jakubprzybytek/RGB-Chain/README.md

#### ToDo
* Fix 3V3 / 5V converter so it works faster
