jakubprzybytek/RGB-Chain/KiCad/RGBChain/RGBChain.kicad_pcb

## KiCad design KiCad/RGBChain/RGBChain.kicad_pcb (2020-12-15)

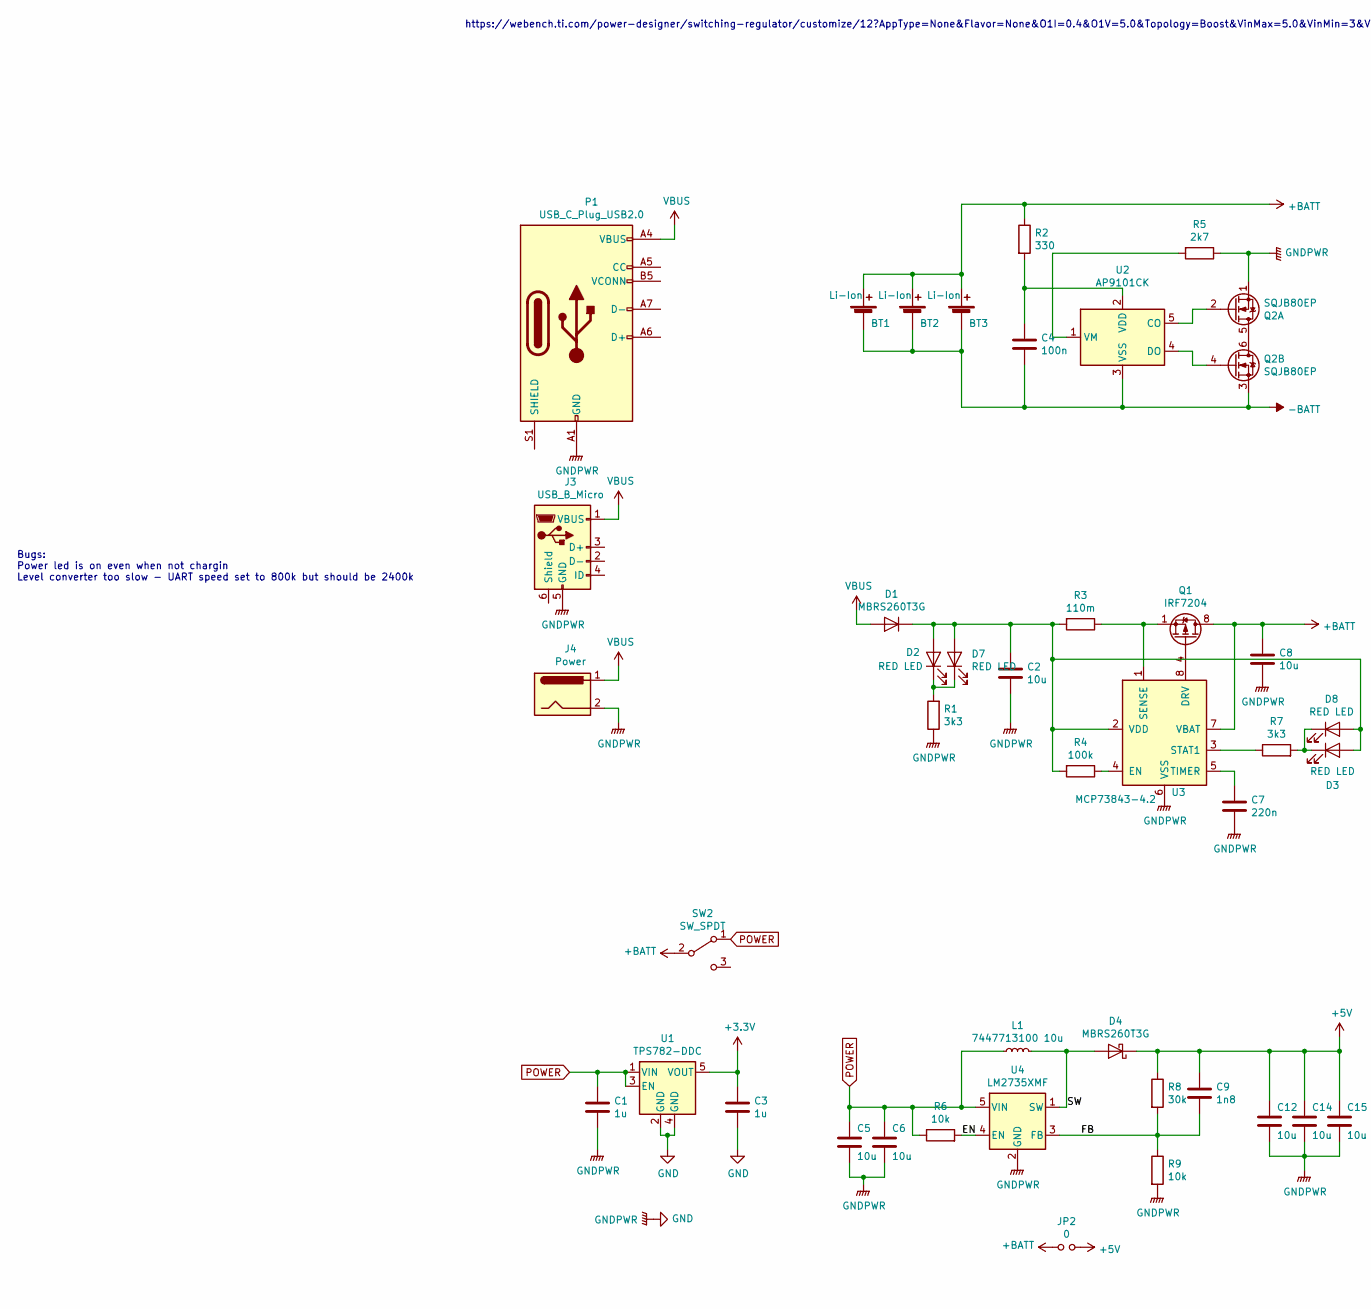
[picture p1: schematic RGBChain.sch, part in row 1, column 1]

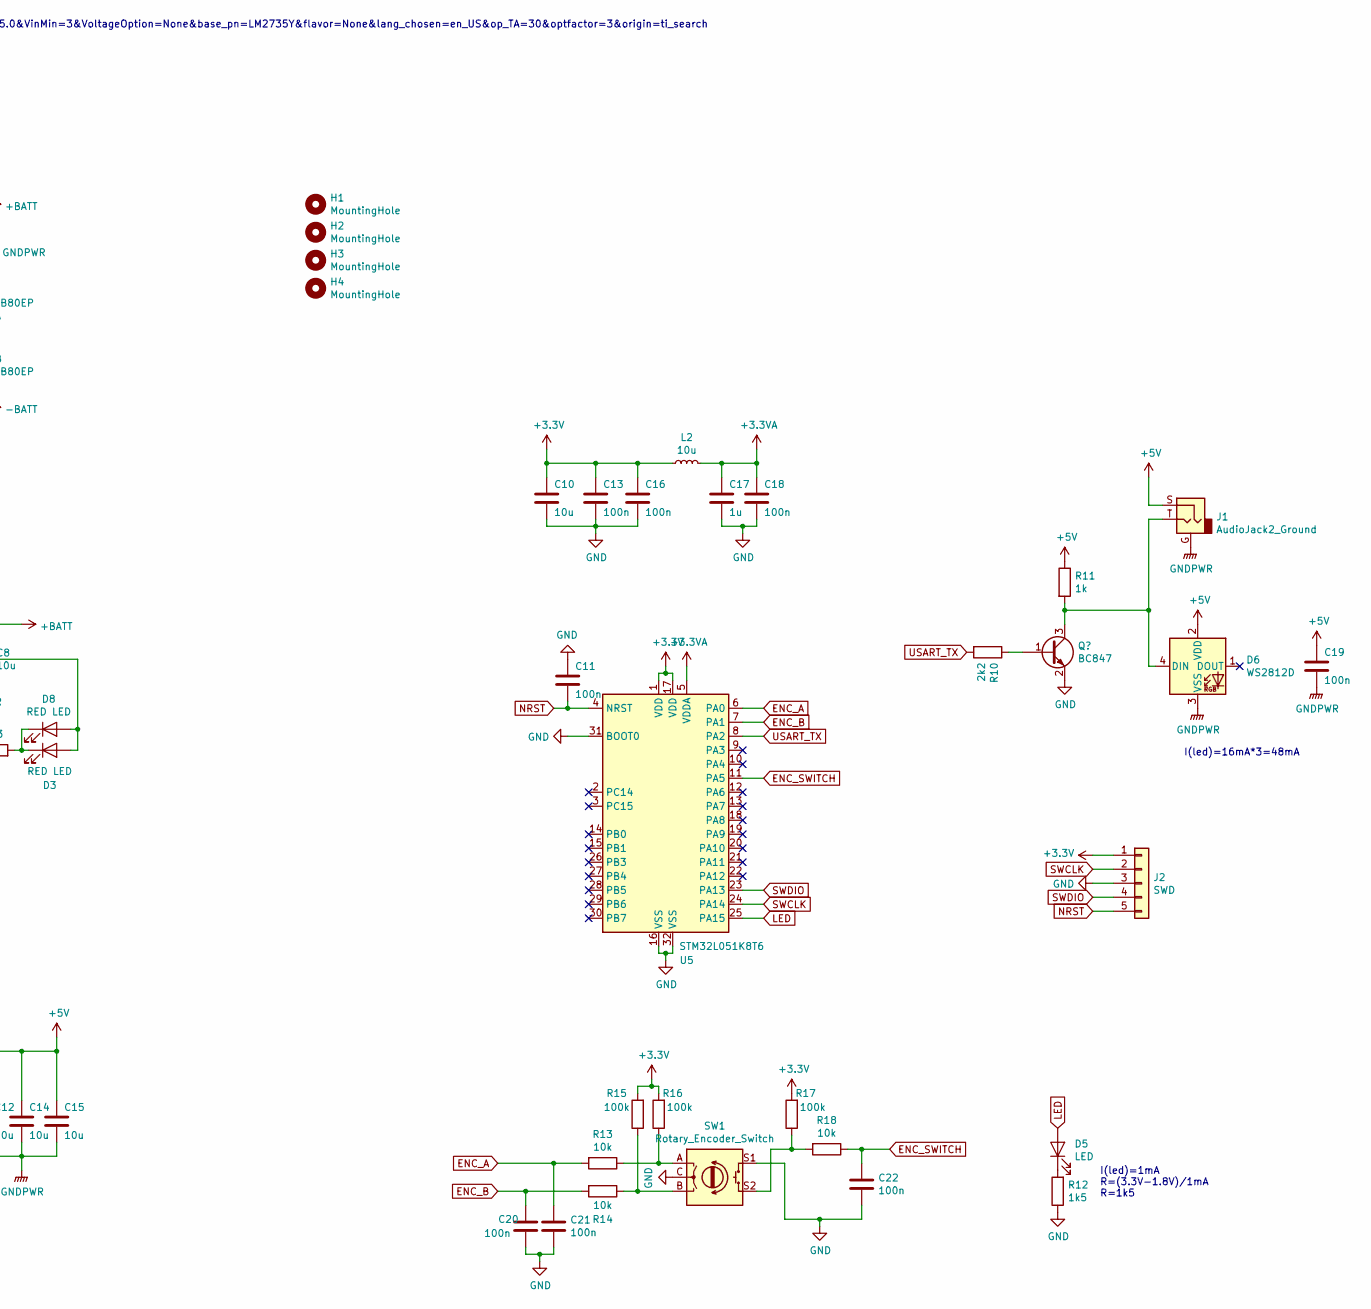
[picture p2: schematic RGBChain.sch, part in row 1, column 2]

Parts:
BT1, BT2, BT3: Li-Ion; BatteryHolder_Keystone_1042_1x18650
C1, C3, C17: 1u; C_0805_2012Metric
C2, C5, C6, C8, C10, C12, C14, C15: 10u; C_0805_2012Metric
C4, C11, C13, C16, C18, C19, C20, C21, C22: 100n; C_0603_1608Metric
C7: 220n; C_0805_2012Metric
C9: 1n8; C_0805_2012Metric
D1, D4: MBRS260T3G; D_SMB
D2, D3: RED LED; LED_0805_2012Metric
D5: LED; LED_0805_2012Metric
D6: WS2812D; LED_D5.0mm-4_RGB
D7, D8: RED LED; LED_D3.0mm
H1, H2, H3, H4: MountingHole; MountingHole_3.2mm_M3
J1: AudioJack2_Ground; Jack_3.5mm_Lumberg_1503_03
J2: SWD; PinHeader_1x05_P2.54mm_Vertical
J3: USB_B_Micro; USB_Micro-B_Molex_47346-0001
J4: Power; PowerSocketSMD
JP2: 0; SolderJumper-2_P1.3mm_Open_Pad1.0x1.5mm
L1: 7447713100 10u; L_Wuerth_WE-PDF_Handsoldering
L2: 10u; L_0805_2012Metric
P1: USB_C_Plug_USB2.0; USB_C_Receptacle_Adam_Tech
Q1: IRF7204; SOIC-8_3.9x4.9mm_P1.27mm
Q2: SQJB80EP; PowerPAK_SO-8_Dual
R1, R7: 3k3; R_0805_2012Metric
R2: 330; R_0805_2012Metric
R3: 110m; R_2512_6332Metric
R4, R15, R16, R17: 100k; R_0603_1608Metric
R5: 2k7; R_0805_2012Metric
R6, R13, R14, R18: 10k; R_0603_1608Metric
R8: 30k; R_0805_2012Metric
R9: 10k; R_0805_2012Metric
R10: 2k2; R_0603_1608Metric
R11: 1k; R_0805_2012Metric
R12: 1k5; R_0805_2012Metric
SW1: Rotary_Encoder_Switch; RotaryEncoder_Alps_EC11E-Switch_Vertical_H20mm_CircularMoun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
SW2: SW_SPDT; NINIGI_5F_M6
U1: TPS782-DDC; SOT-23-5
U2: AP9101CK; SOT-23-5
U3: MCP73843-4.2; MSOP-8_3x3mm_P0.65mm
U4: LM2735XMF; SOT-23-5
U5: STM32L051K8T6; LQFP-32_7x7mm_P0.8mm

Connections:
+3.3VA: C17.1, C18.1, L2.2, U5.5 (VDDA)
+3V3: C3.1, C10.1, C13.1, C16.1, J2.1, L2.1, R15.2, R16.2, R17.2, U1.5 (VOUT), U5.1 (VDD), U5.17 (VDD)
+5V: C9.1, C12.1, C14.1, C15.1, C19.1, D4.1 (K), D6.2 (VDD), J1.S, JP2.2, R8.1, R11.1
+BATT: BT1.1 (+), BT2.1 (+), BT3.1 (+), C8.1, JP2.1, Q1.5 (D), Q1.6 (D), Q1.7 (D), Q1.8 (D), R2.1, SW2.2 (B), U3.7 (VBAT)
-BATT: BT1.2 (-), BT2.2 (-), BT3.2 (-), C4.2, Q2.3 (S2), U2.3 (VSS)
/EN: R6.2, U4.4 (EN)
/FB: C9.2, R8.2, R9.1, U4.3 (FB)
/SW: D4.2 (A), L1.2, U4.1 (SW)
ENC_A: C21.1, R13.2, U5.6 (PA0)
ENC_B: C20.1, R14.2, U5.7 (PA1)
ENC_SWITCH: C22.1, R18.1, U5.11 (PA5)
LED: D5.2 (A), U5.25 (PA15)
NRST: C11.2, J2.5, U5.4 (NRST)
unnamed: C2.1, D1.1 (K), D2.2 (A), D3.2 (A), D7.2 (A), D8.2 (A), R3.2, R4.2, U3.2 (VDD)
unnamed: C4.1, R2.2, U2.2 (VDD)
unnamed: C7.1, U3.5 (TIMER)
unnamed: D2.1 (K), D7.1 (K), R1.2
unnamed: D3.1 (K), D8.1 (K), R7.2
unnamed: D5.1 (K), R12.2
unnamed 20: D6.4 (DIN), J1.T, R11.2; also elsewhere on the board
unnamed: Q1.1 (S), Q1.2 (S), Q1.3 (S), R3.1, U3.1 (SENSE)
unnamed: Q1.4 (G), U3.8 (DRV)
unnamed: Q2.2 (G2), U2.5 (CO)
unnamed: Q2.4 (G2), U2.4 (DO)
unnamed: Q2.5 (D2), Q2.6 (D2)
unnamed: R4.1, U3.4 (EN)
unnamed: R5.2, U2.1 (VM)
unnamed: R7.1, U3.3 (STAT1)
unnamed: R13.1, R16.1, SW1.A
unnamed: R14.1, R15.1, SW1.B
unnamed: R17.1, R18.2, SW1.S2
POWER: C1.1, C5.1, C6.1, L1.1, R6.1, SW2.1 (A), U1.1 (VIN), U1.3 (EN), U4.5 (VIN)
SWCLK: J2.2, U5.24 (PA14)
SWDIO: J2.4, U5.23 (PA13)
VBUS: D1.2 (A), J3.1 (VBUS), J4.1, P1.A4 (VBUS), P1.A9 (VBUS), P1.B4 (VBUS), P1.B9 (VBUS)

Notes on the sheet:
I(led)=1mA R=(3.3V-1.8V)/1mA R=1k5
https://webench.ti.com/power-designer/switching-regulator/customize/12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
I(led)=16mA*3=48mA
Bugs: Power led is on even when not chargin Level converter too slow - UART speed set to 800k but should be 2400k

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
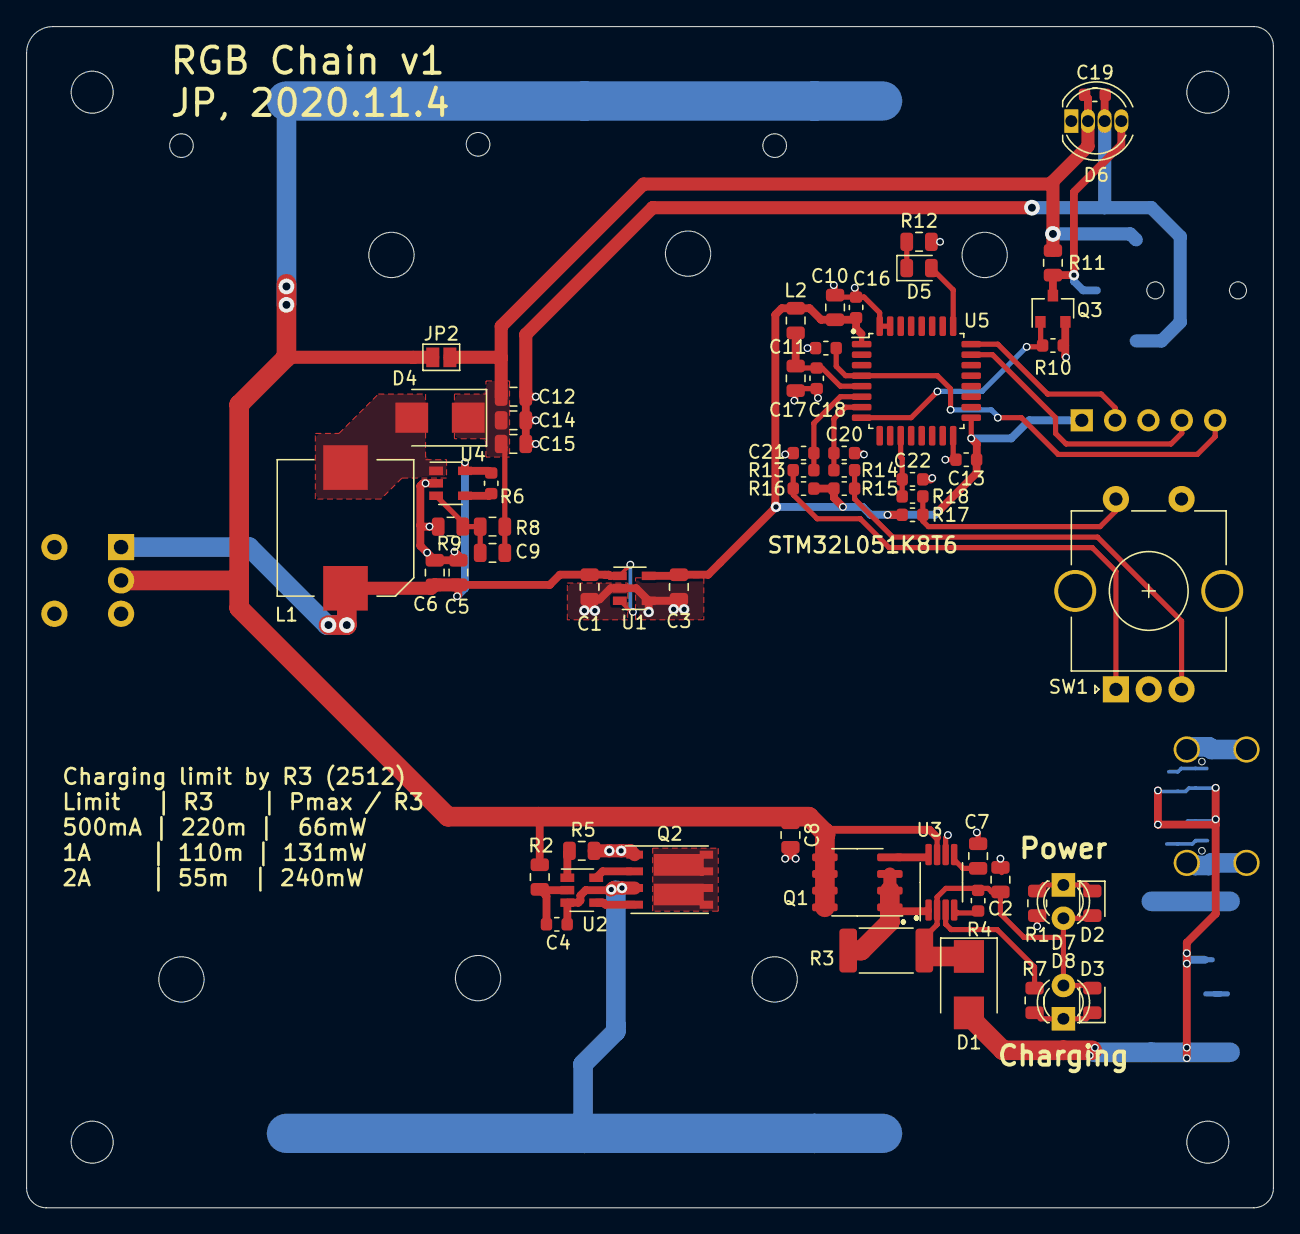
[picture p3: board RGBChain.kicad_pcb from above]

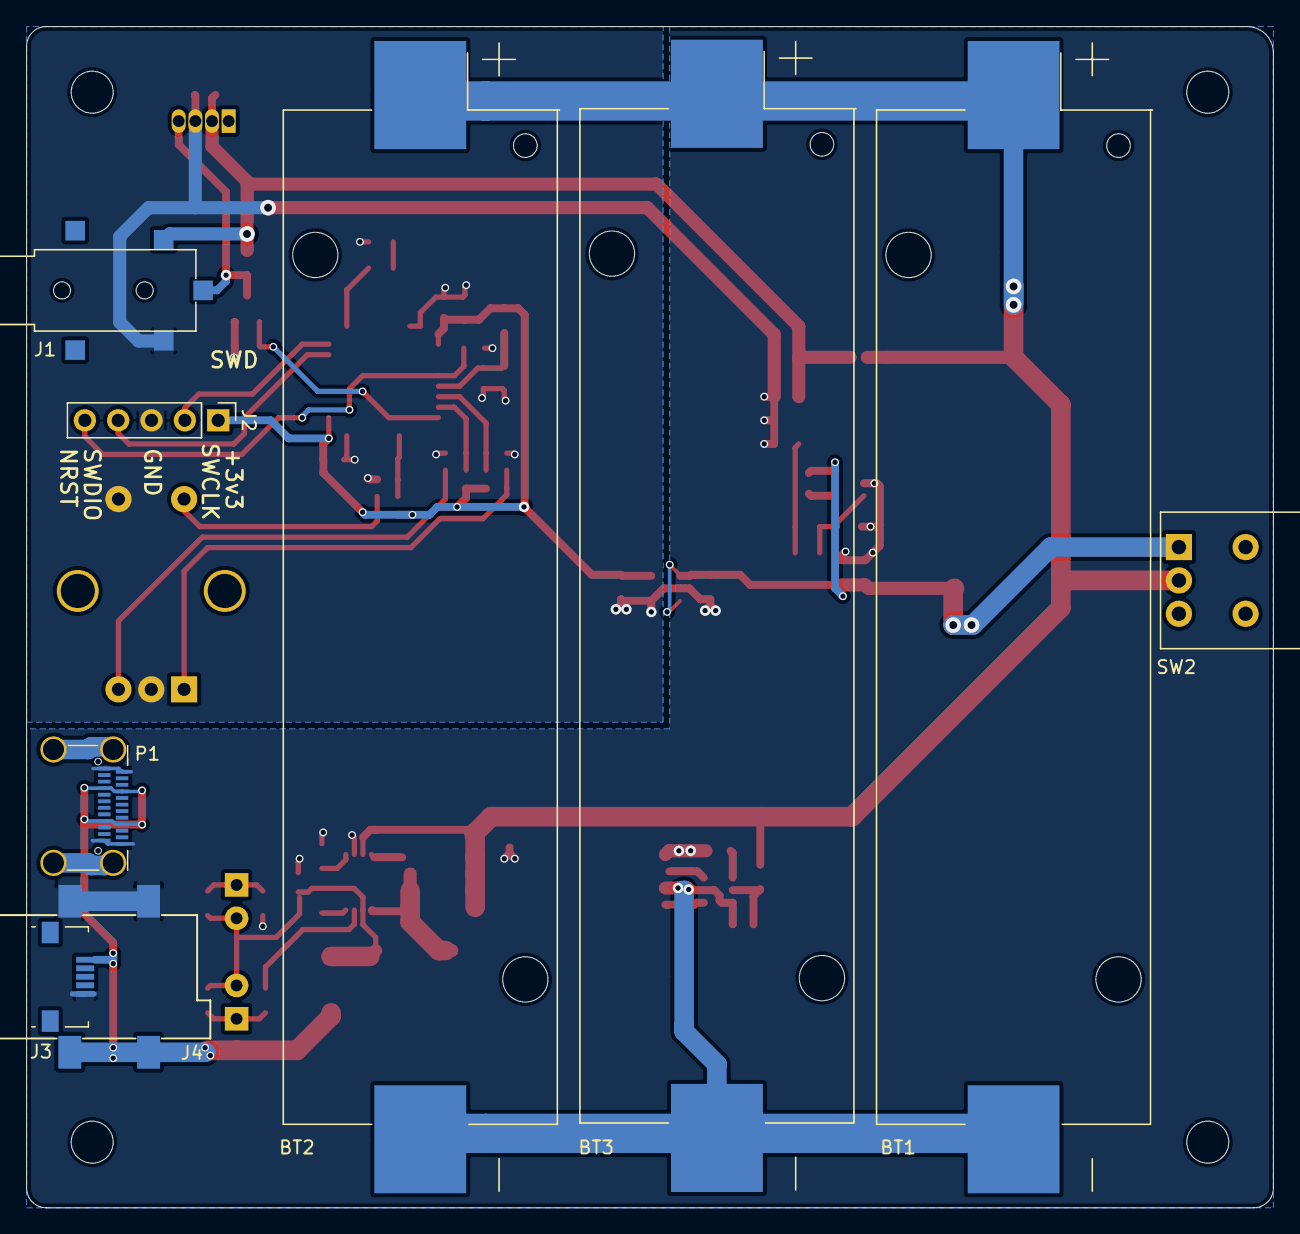
[picture p4: board RGBChain.kicad_pcb from below]

Board: 2 copper layers, 95.0 x 90.0 mm, 73 parts (9 on the bottom side), 37 nets.

Other parts of the board:
Q3: IRLML2502; SOT-23

Their connections:
unnamed 20: Q3.3; also elsewhere on the board
