jakubprzybytek/RGB-Chain/STM32CubeIDE/RGBChain.ioc

Mcu.UserName=STM32L010K8Tx
PA0.GPIO_Label=EncoderA
PA0.Signal=S_TIM2_CH1
PA1.GPIO_Label=EncoderB
PA1.Signal=S_TIM2_CH2
PA13.Signal=SYS_SWDIO
PA14.Signal=SYS_SWCLK
PA15.GPIO_Label=Led
PA15.Signal=GPIO_Output
PA2.GPIO_Label=WS2812
PA2.Signal=USART2_TX
PA3.Signal=USART2_RX
PA5.GPIO_Label=EncoderSwitch
PA5.Signal=GPXTI5
