jakubprzybytek/RGB-Chain/STM32CubeIDE/Core/Inc/main.h

#define EncoderA_Pin GPIO_PIN_0
#define EncoderA_GPIO_Port GPIOA
#define EncoderB_Pin GPIO_PIN_1
#define EncoderB_GPIO_Port GPIOA
#define WS2812_Pin GPIO_PIN_2
#define WS2812_GPIO_Port GPIOA
#define EncoderSwitch_Pin GPIO_PIN_5
#define EncoderSwitch_GPIO_Port GPIOA
#define EncoderSwitch_EXTI_IRQn EXTI4_15_IRQn
#define Led_Pin GPIO_PIN_15
#define Led_GPIO_Port GPIOA
