jakubprzybytek/RGB-Chain/(commit log)

2020-10-24 Init commit
    [RGBChain.kicad_pcb, RGBChain.sch]
2020-10-25 PCB done
    [RGBChain.kicad_pcb, RGBChain.sch]
2020-10-30 PCB more work
    [RGBChain.kicad_pcb, RGBChain.sch]
2020-11-04 Last pcb changes
    [RGBChain.kicad_pcb, RGBChain.sch]
2020-12-08 Single colour effect implemented
    [RGBChain.cfg, RGBChain.sch]
2020-12-10 More work on effects
    [RGBChain.sch]
2020-12-11 Some refactoring with colours and encoder
2020-12-15 More effects. Refactoring
    [RGBChain.kicad_pcb, RGBChain.sch]
2021-01-01 Led tweaks
    [RGBChain.cfg]
